Mutzi1211/Recovery/README.md

v 1.0 ist die alte Version basierend auf dem SparkFun 9DoF Razor IMU M0

v 2.0 ist gerade in Arbeit und wird auf dem SparkFun OpenLog Artemis basieren
