Mutzi1211/Recovery/v1.0/README.md

# Recovery
Repo for the Recovery Project at SL-OP

Projekt zur Dokumentation des MoRaBa Recovery-Experimentes am DLR-School-Lab in Oberpfaffenhofen 

Ziel: 
Dokumentation der bestehenden Soft- und Hardware zur Sicherstellung des reibungslosen Betriebs des Experimentes, auch nach              Abgang aller daran aktuell beteiligten Betreuer

First Upload (Stand 24.08.18):

3 CAD-Dateien:

	side_deploy_v2.1 - ignition_unit

	side_deploy_v2.1 - lower_adapter

	side_deploy_v2.1 - door

Teileliste:

	Teileliste.xlsx
	
Firmware:

	https://github.com/turbinenreiter/9DOF_Razor_IMU/tree/add-baro
