Mutzi1211/Recovery/v1.0/Beschleunigung in z Richtung.pdf

# Beschleunigung in z Richtung – Erlä uterungen

Die Beschleunigung der Rakete lässt sich in 3 Phasen einteilen:

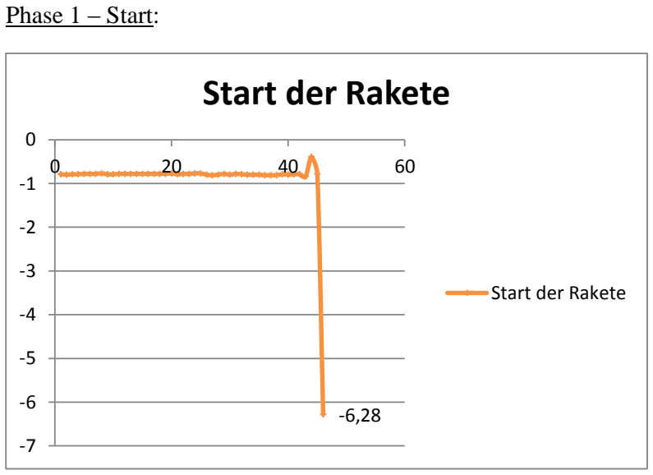
[picture p1: figure]
Phase 1 – Start:; Start der Rakete

Während die Rakete steht, ist die Beschleunigung bei (etwa) -1*g. In dem Moment, in dem die Rakete gestartet wird, erfährt sie eine Beschleunigung von -6.28*g.

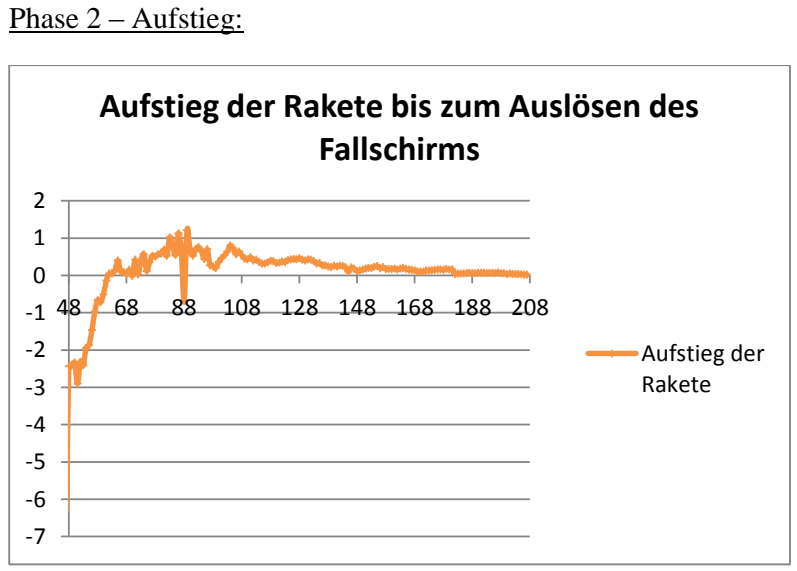
[picture p2: figure]
Phase 2 – Aufstieg:; Fallschirms; Aufstieg der Rakete

Beim Aufstieg der Rakete nimmt die Beschleunigung aufgrund der Luftreibung stetig ab. Bei Zähleinheit 208 lag der Beschleunigungswert 32mal unter 0.1*g und der Fallschirm wird daher ausgelöst.

### Aufstieg der Rakete bis zum Auslösen des

Phase 3 – Fall mit Fallschirm:

Da der Fall der Kapsel nicht ideal verläuft, schwanken die Werte, jedoch lässt sich erkennen, dass die Geschwindigkeit etwa konstant ist und somit die Beschleunigung 0.

Bei Zähleinheit 400 befindet sich die Kapsel wieder auf dem Boden und der Beschleunigungswert pendelt sich wieder bei 1*g ein.

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
208 | 308 | 408 | 508

## Fall mit Fallschirm

Fall mit Fallschirm
