Mutzi1211/Recovery/v1.0/Moraba im Schulkontext.pdf

### MoRaBa – Anwendungsmöglichkeiten im Schulkontext

### Mögliche Anwendungsgebiete im Lehrplan:

### Jahrgangsstufe 8:

– Ph8 Lernbereich 1: Kräfte und ihre Wirkungen (ca. 16 Std.)

Kompetenzerwartungen:

Die Schülerinnen und Schüler ...
- beziehen die Richtung einer Kraft bei Anwendung des zweiten Newton’schen Gesetzes ein, indem sie in alltagsrelevanten Kontexten zeichnerisch sowohl die aus mehreren Kräften resultierende Kraft als auch die Komponenten einer Kraft in vorgegebene Richtungen bestimmen.

– Ph8 2.1: Mechanische Energie (ca. 14 Std.)

Kompetenzerwartungen:

Die Schülerinnen und Schüler ...
- beschreiben Vorgänge in Alltag, Technik und Natur mithilfe von Energieumwandlungen, insbesondere mechanische Vorgänge mithilfe der kinetischen Energie, der Höhenenergie und der Spannenergie. Hierbei verwenden sie fachsprachlich korrekte Formulierungen.
- nutzen das Prinzip der Energieerhaltung, um die bei Energieumwandlungen beteiligten Energieformen quantitativ zu bilanzieren. Sie bestimmen insbesondere Werte der Höhenenergie und der kinetischen Energie.

### Jahrgangsstufe 9:

– Ph9 Lernbereich 2: Energie- und Impulserhaltung in der Mechanik (ca. 10 Std.)

Kompetenzerwartungen:

Die Schülerinnen und Schüler ...
- verdeutlichen in alltagsrelevanten Kontexten, dass Kräfte gemäß dem Wechselwirkungsgesetz stets paarweise auftreten. Sie grenzen ein solches Kräftepaar von einem Kräftepaar im Gleichgewicht ab.
- nutzen den Energieerhaltungssatz zum Aufstellen von Größengleichungen und nehmen Äquivalenzumformungen vor, um mechanische Größen zu berechnen. Mit dem Impulserhaltungssatz führen sie quantitative Betrachtungen für einfache Stoßvorgänge durch und erkennen allgemein in Erhaltungsgrößen ein grundlegendes Konzept der Physik.

### Jahrgangsstufe 10:

– Ph10 Lernbereich 1: Bewegungen und ihre Modellierung in der Physik (ca. 17 Std.)

Kompetenzerwartungen:

Die Schülerinnen und Schüler ...
- erstellen und interpretieren Zeit-Weg- und Zeit-Geschwindigkeits-Diagramme von Bewegungen in alltagsrelevanten Kontexten und stellen Beziehungen zwischen den Diagrammen und linearen bzw. quadratischen Bewegungsfunktionen her.

– Ph10 4.2: Vertiefung prozessbezogener Kompetenzen anhand ausgewählter weiterer Inhalte (ca. 18 Std.)

Kompetenzerwartungen:

Die Schülerinnen und Schüler ...
- entwickeln physikalische Fragestellungen anknüpfend an ihnen bekannte Alltagssituationen. Um diese zu beantworten, verwenden sie experimentelle Methoden oder andere fachtypische Arbeitsweisen (z.B. Computermodellierung, Mathematisieren); ggf. setzen sie hierbei den Computer als Hilfsmittel zur Erfassung und Verarbeitung von Messwerten ein (z.B. Videoanalyse). Sie vergleichen experimentelle Ergebnisse mit theoretischen Vorhersagen und erklären Abweichungen.
- dokumentieren selbständig experimentelle Untersuchungen sowie durch andere fachtypische Arbeitsweisen (z.B. Computermodellierung, Mathematisieren, Quellenarbeit oder Diskussion) gewonnene Ergebnisse. Hierbei legen sie Art und Struktur der Dokumentation nach fachlichen Gesichtspunkten selbständig fest; insbesondere wählen sie die Darstellungsformen sach- und adressatengerecht aus.

Inhalte zu den Kompetenzen:
- Physik des Fliegens: physikalische Gesetze im Zusammenhang mit dem Fliegen, Experimente mit dem Windkanal, Bau von Modellraketen, Vermessung der Flughöhe

### Physikalischer Hintergrund:

### Senkrechter Wurf:

Trotz längerer Beschleunigungsphase (und vor allem nicht konstanter Beschleunigung) beim Start der Rakete kann der Flug mit einem senkrechten Wurf verglichen werden. Die SuS messen dafür während der Flüge die Zeiten vom Start bis zur Landung der Rakete. Im Anschluss kann die maximale Flughöhe über den Ansatz h= ½ * g * t² abgeschätzt werden. Dies ist gerade für die niedrigeren Jahrgangsstufen ein guter Ansatz, wobei die Grenzen der Näherung erläutert werden sollten.

Wenn die SuS bereits den Impulserhaltungssatz kennen und die Schwierigkeit der Aufgabenstellung erhöht werden soll, kann folgender Ansatz gewählt werden:

1. Bestimmung der Masse der Rakete vor dem Start:

ρLuft =

p
RST

=

5 ⋅ 10⁵ N
m²
287,058 Nm
kg ⋅ K

⋅ 293K

= 5,94

kg
m³

mLuft =

5,94 kg
m³
1000 1
m³

= 5,94 ⋅ 10⁻³kg ⇒ mRakete = m500mlWasser + mLuft + mRaketeleer = 1,00594kg

2. Bestimmung der Startgeschwindigkeit der Rakete: Kraft auf Wasser in der Flasche: FH2O = pFlascℎe ∗ A + m ⋅ g = 5 ⋅ 10⁵

N
m²

⋅ (0,05m)² ⋅ π + 0,5kg ⋅ 9,81

N
kg = 3,93 ⋅ 10³N

⇒ aH2O =

3,93 ⋅ 10³N
0,5kg | = 7,86 ⋅ 10³ m
| s²
vH2O = 7,86 ⋅ 10³ m
s²

⋅ 0,005s(geschätzte Zeit für Austritt des Wassers)

⇒ vH2O = 39,3

| m
| s
⇒ GescℎwindigkeitderRaketeüberImpulserℎaltungssatz:

vR =

0,5kg ∗ 39,3 | m
| s
1,00594kg − 0,5kg = 39,3
| m
| s
3. Einbezug des Luftwiderstands:

FLR =

1
2

⋅ A ⋅ cW ⋅ ρLuft ⋅ v²; dabeiistcWeinfürFormdesKörpersspezifiscℎerWert (ℎierfürFlugzeug)undderLuftdruckwirdaufMeeresspiegelℎöℎegenäℎert;

FLR =

1
2
⋅ (0,05m)² ⋅ π ⋅ 0,08 ⋅ 1,2041 | kg
| m³ ⋅ (39,3 m
| s )² = 0,584N
4. Bestimmung der maximalen Flughöhe:

Abbremsen durch Luftwiderstand: aBrems =

FLR
mR − 0,5kg = 1,17

m
s²
abgeschätzte Steigzeit:t = 3s(ausVideoanalyse)

ℎmax = −

1
2

⋅ t² ⋅ (g + aBrems) + v0 ⋅ t = −

1
2

⋅ 9s² ⋅ 10,98 + 39,3

m
s

⋅ 3s = 68,4m

Hinweis:

### Berechnungen mit Hilfe der Rakete

– Auswertung am Computer:

Die Daten der Speicherkarte der Boardelektronik können ganz einfach über Excel ausgewertet werden.

– Auswertung mit Apps (Viana):

Mit der App Viana können Bewegungen gefilmt und anschließend analysiert werden. Allerdings funktioniert diese App nur auf Apple Geräten.
Ein Ipad wäre dafür ideal da der Bildschirm größer ist. Dies ist wichtig um eine präzisere Erfassung der Bewegung sowie eine präzisere Festlegung des Maßstabes und des Koordinatensytems zu ermöglichen. Die Daten können dann eventuell anschließend nach Geogebra exportiert werden.

### Weitere Hintergründe/Weiterführende Themen:

### Astronomie:

Der Raketenflug kann in der 10. Jahrgangsstufe als Brücke zwischen Mechanik und Astronomie genutzt werden. Anhand dieses authentischen Kontextes kann zunächst ein kurzer Exkurs zur aktuellen Nutzung von Raketen beziehungsweise zu Weltraumforschung gemacht werden. Dabei kann auf thematisiert werden, dass z.B. die ISS sich auf einer Kreisbahn um die Erdkugel bewegt und kann als Überleitung zu den (antiken) Weltbildern dienen.
