Mutzi1211/Recovery/v2.0/Hardware/Materialliste.xlsx

Sparkfun OpenLog Artemis
Bezeichnung | Bezugsquelle | Preis | Bemerkung
Ignition Unit | 3D Druck (Meltwerk) | 47.72 € | side_deploy_v2.1 - ignition_unit.stl
Door | 3D Druck (Meltwerk) | 9.81 € | side_deploy_v2.1 - door.stl
Lower Adapter | 3D Druck (Meltwerk) | 18.93 € | side_deploy_v2.1 - lower_adapter.stl
Fallschirm 45cm | Modellraketen Klima | 15.90 € | http://www.raketenmodellbau-klima.de/Raketenmodellbau/Ersatz-Bauteile/Fallschirme-Flatterbaender/Fallschirm-45cm.htm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
@@ | @@ | @@ | @@
Minikamera | ebay (eletoponline365) | 38.56 € | Keychain 808#16, https://www.ebay.de/itm/Mini-DVR-808-16-V3-Lens-D-Car-Key-Chain-Micro-Camera-HD-720P-Pocket-Camcorder/180937263580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
Wasserwaage | Conrad | 3.29 € | https://www.conrad.de/de/kreuz-wasserwaage-55-mm-basetech-813395-kalibriert-nach-werksstandard-ohne-zertifikat-813395.html
SparkFun OpenLog Artemis | Sparkfun | $54.95 | https://www.sparkfun.com/products/16832
SparkFun Atmospheric Sensor Breakout - BME280 (Qwiic) | Sparkfun | $16.50 | https://www.sparkfun.com/products/15440
Lithium Ion Battery - 400mAh | Sparkfun | $5.50 | Achtung: kann nicht versandt werden!!! https://www.sparkfun.com/products/13851
