Mutzi1211/Recovery/v1.0/Materialliste.pdf

# Materialliste Wasserrakete

- Bauteile Sensorik:
Produkt | Preis | Bestellung

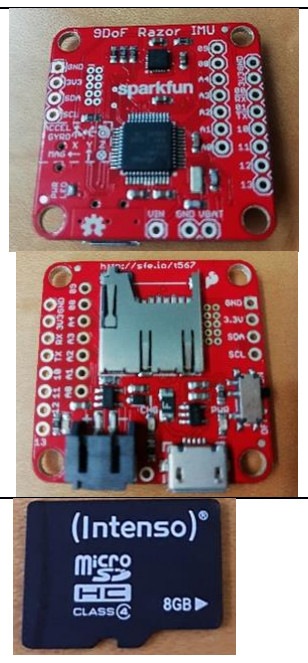
[picture p3: figure]

- Sparkfun: 9DoF Razor IMU (GitHub) | 30,94€ | https://www.mouser.de/ProductDetail/SparkFun/SE N-14001?qs=%2fha2pyFadu hinf7GTK6Rfjxa5fBzzVj017 Uyy8r2f3ctWWnsFvpad%2 foCZtb%252bI2Z7
- Mikro-Speicherkarte 8GB | 6,99€ | https://www.reichelt.de/microsdhc-speicherkarte-8gb-xlyne-class-4-xlyne-7408000-p144856.html?&trstct=pos_5

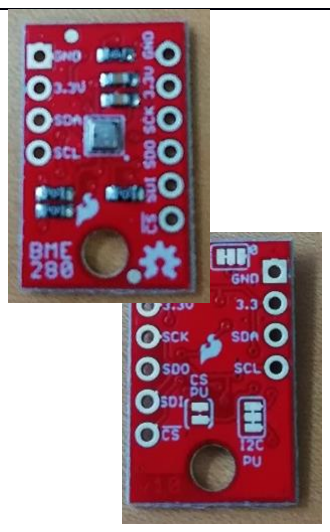
[picture p4: figure]

- Sparkfun: BME280 Atmospheric Sensor Breakout Weitere Informationen : https://www.s parkfun.com (https://www.sparkfun.com/) /products/136 76 | 17,18€ | https://www.mouser.de/ProductDetail/SparkFun/SE N-13676?qs=sGAEpiMZZMu WWq7rhECaKb4KuHPVgn HEOY7WYwd4z04%3d

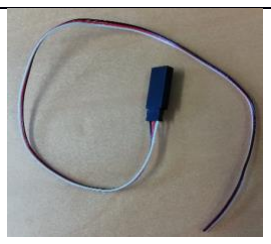
[picture p5: figure]

- 3 Wire Assembly | 1,99 € | https://www.conrad.de/de/servo-gegenkabel-1x-jr-stecker-1x-offenes-ende-300-mm-008-mm-flach-modelcraft-208318.html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 cts
- Sparkfun: Break Away Headers -Straight | 1,29€ | https://www.mouser.de/ProductDetail/SparkFun/PR T-12693?qs=sGAEpiMZZMu M1nRwI3zz2UpCr55iWBr5 3%2fclP%252bN7eq%252 bDtqzvtDeeFg%3d%3d

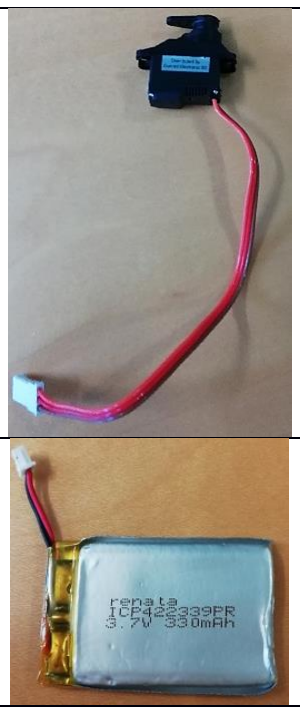
[picture p6: figure]

- Conrad: Modelcraft Mini-Servo Y-3009 Analog-Servo | 6,99€ | https://www.conrad.de/de/modelcraft-mini-servo-mc1811-analog-servo-getriebe-material-kunststoff-stecksystem-jr-275460.html
- Sparkfun: Lithium Ion Battery – 400mAh | 4,26€ | https://eckstein-shop.de/LiPo-Akku-Lithium-Ion-Polymer-Batterie-37V-480mAh-JST-PH-Connector
- Bauteile Rakete:
- Wasserraketenset

vgl. gelbe Kästen in
untenstehender Abbildung

32,90 € http://www.raketenmodel lbau- klima.de/Raketenmodellb au/Wasser- Luftraketen/Aqua-Star- Starterset.htm?shop=raket enklima&SessionId=&a=ar ticle&ProdNr=6044&t=23 &c=34&p=34

- Bauteile Fallschirmkammer:

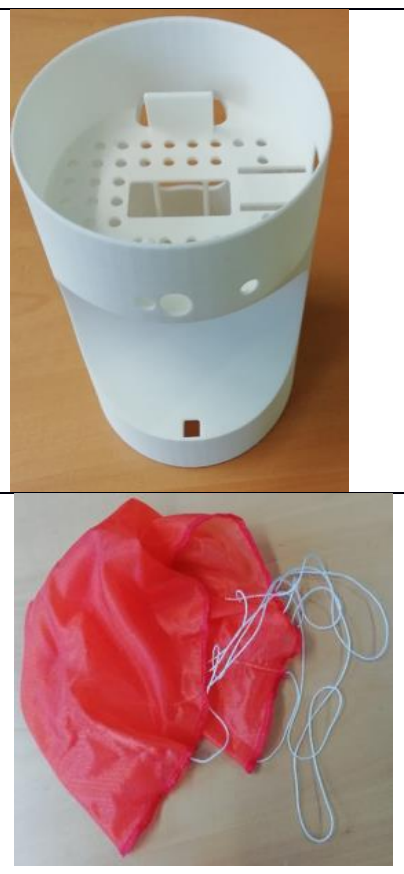
[picture p7: figure]

- 3D gedrucktes Gehäuse | 47,72 € | side_deploy_v2.1-ignition_unit.stl https://www.meltwerk.com/index.php
- Raketenmodellb au Klima GmbH: Fallschirm | 11,90€ | http://www.raketenmode llbau-klima.de/Raketenmodellb au/Ersatz-Bauteile/Fallschirme-Flatterbaender/Fallschirm -45cm.htm?shop=raketen klima&SessionId=&a=arti cle&ProdNr=8590&t=23&

| | c=88&p=88

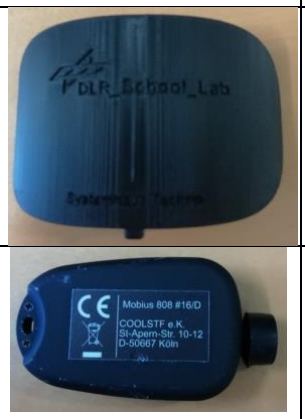
[picture p8: figure]

- 3D gedruckte Abdeckung | 9,81 € | side_deploy_v2.1-door.stl https://www.meltwerk.com/index.php
- Mobius: Kamera 808 | 20,00 € | https://www.ebay.de/itm/Mini-DVR-808-16-V3-Lens-D-Car-Key-Chain-Micro-Camera-HD-720P-Pocket-Camcorder/180937263580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 AAOxycmBS01Wl
- Berger Camping und Freizeit: Mini Wasserwaage • 3D gedruckte Halterung | 5,50€ 18,93€ | https://www.conrad.de/de/basetech-813395-kreuz-wasserwaage-55-mm-kalibriert-nach-werksstandard-ohne-zertifikat-813395.html (https://www.conrad.de/de/basetech-813395-kreuz-wasserwaage-55-mm-kalibriert-nach-werksstandard-ohne-zertifikat-813395.html) side_deploy_v2.1-lower_adapter.stl https://www.meltwerk.com/index.php
- Sonstiges: Tape; Schnur; Büroklammer

Vollständiger Bausatz:

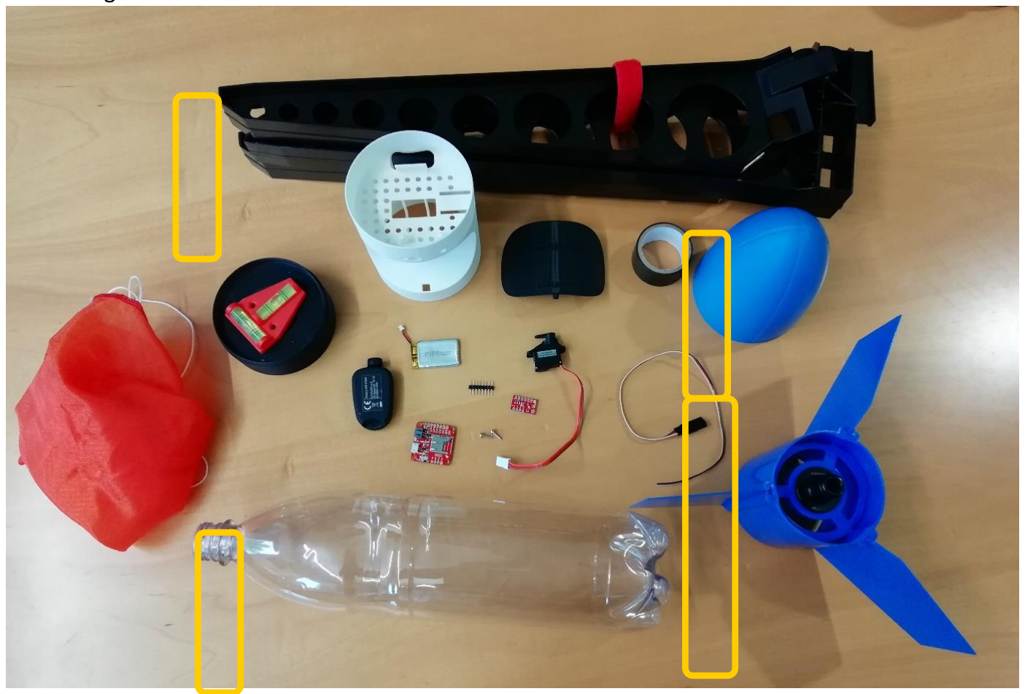
[picture p9: figure]

GESAMTKOSTEN: | 216,40€
