Mutzi1211/Recovery/v2.0/Hardware/side_deploy_v2.1 - ignition_unit.stl

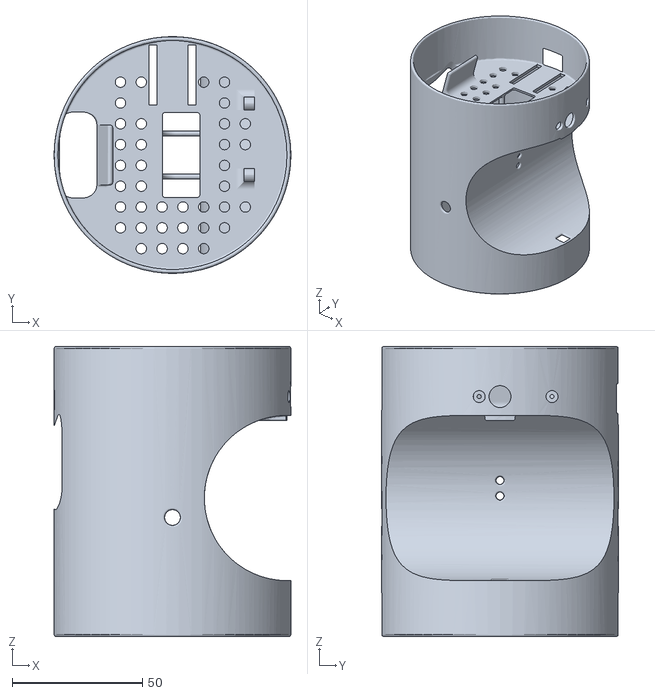
[picture p10: CAD file, 2018-08-24]
v2.0/Hardware/side_deploy_v2.1 - ignition_unit.stl
91.0 x 91.0 x 111.5
