Mutzi1211/Recovery/v2.0/Hardware/side_deploy_v2.1 - door.stl

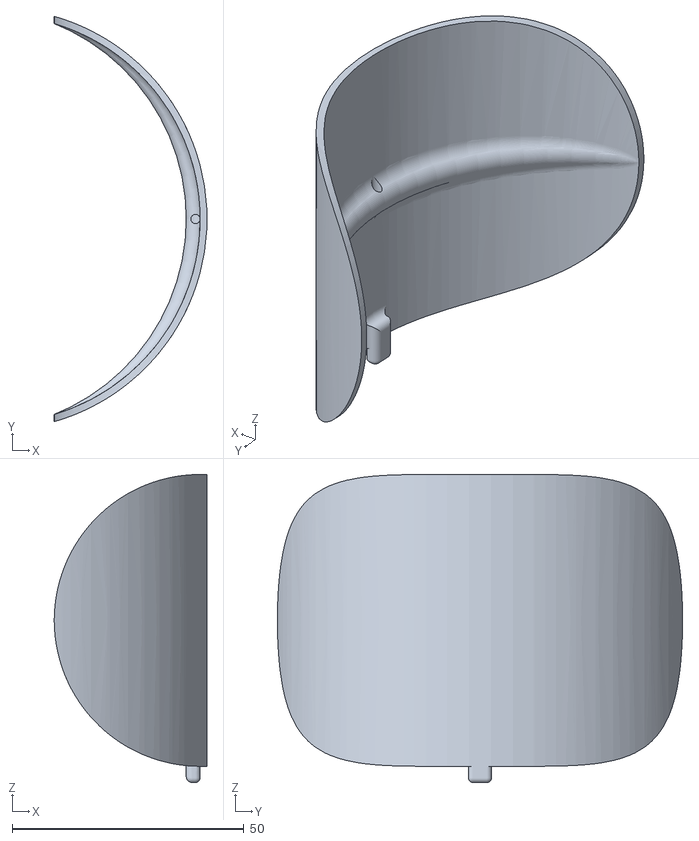
[picture p11: CAD file, 2018-08-24]
v2.0/Hardware/side_deploy_v2.1 - door.stl
32.9 x 87.5 x 66.5
