Mutzi1211/Recovery/v2.0/Hardware/side_deploy_v2.1 - lower_adapter.stl

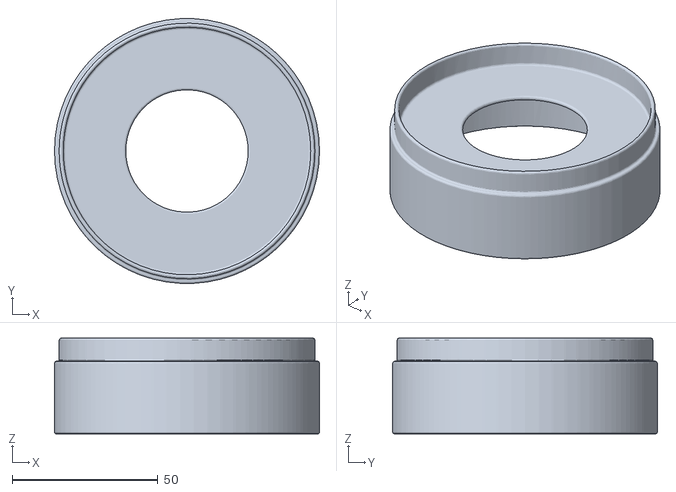
[picture p12: CAD file, 2018-08-24]
v2.0/Hardware/side_deploy_v2.1 - lower_adapter.stl
91.0 x 90.9 x 32.9
