Mutzi1211/Recovery/(commit log)

2018-08-24 Add files via upload
    CAD-Files
    [side_deploy_v2.1 - door.stl, side_deploy_v2.1 - ignition_unit.stl, side_deploy_v2.1 - lower_adapter.stl]
2018-08-24 Add files via upload
    List of Parts
    [Teileliste.xlsx]
2024-01-05 updating to Artemis OpenLog
    [Materialliste.xlsx, Teileliste.xlsx, side_deploy_v2.1 - door.stl, side_deploy_v2.1 - ignition_unit.stl, side_deploy_v2.1 - lower_adapter.stl]
